dangorogoro/DangoromouseZero-PCB/pcb/dxf/top_board.dxf

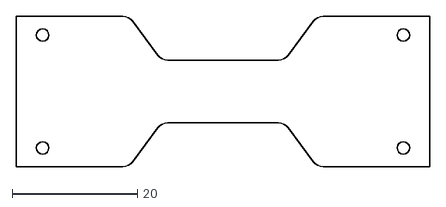
[picture p1: CAD file, 2021-10-21]
pcb/dxf/top_board.dxf
66.0 x 24.0
