dangorogoro/DangoromouseZero-PCB/pcb/dxf/board.dxf

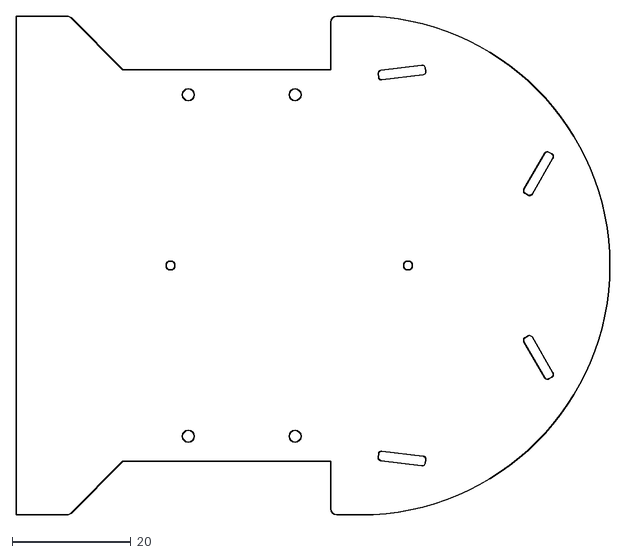
[picture p2: CAD file, 2021-10-18]
pcb/dxf/board.dxf
100.0 x 84.0
