dangorogoro/DangoromouseZero-PCB/pcb/doc/ZeroPCB.pdf

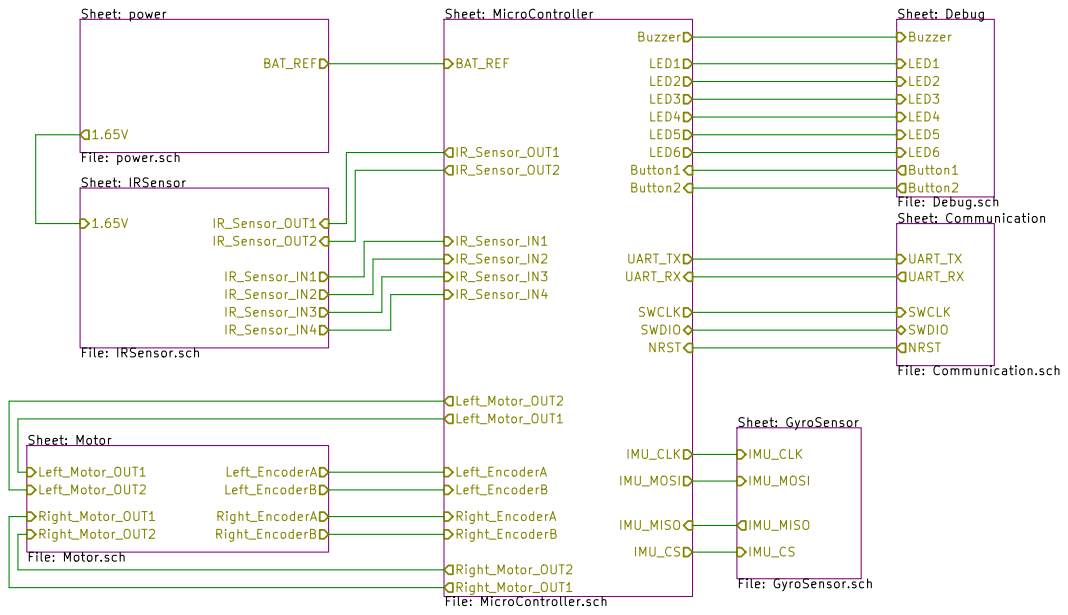
[picture p3: page 1]

File: Debug.sch
Sheet: Communication File: Communication.sch UART_TX UART_RX

Sheet: Motor File: Motor.sch

Id: 1/8 Title: File: ZeroPCB.sch Sheet: /

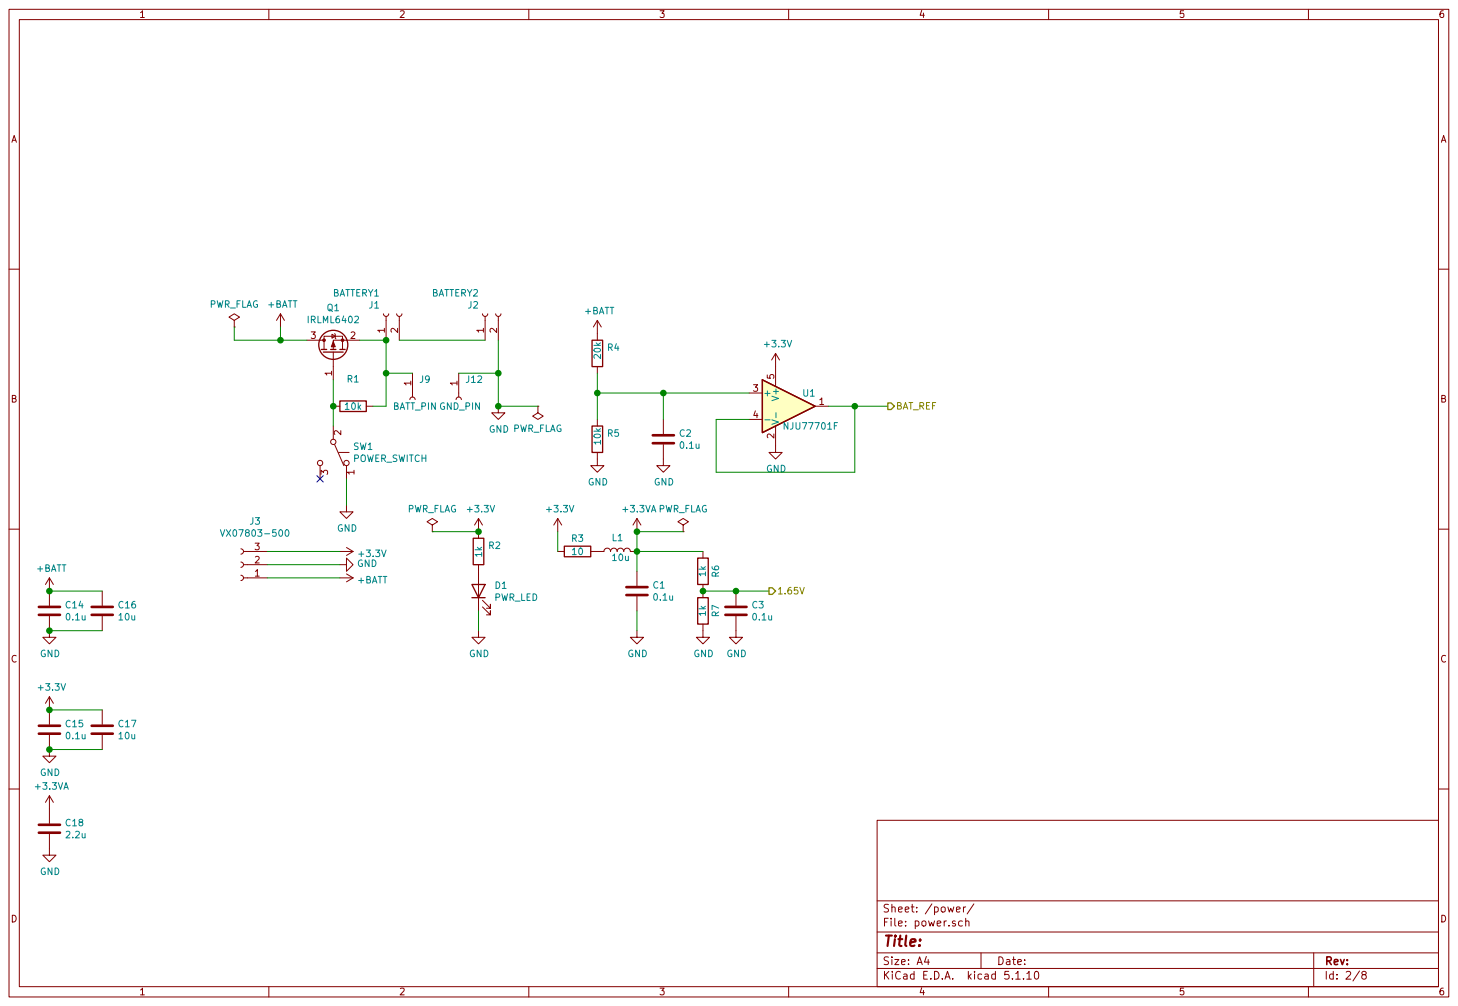
[picture p4: page 2]

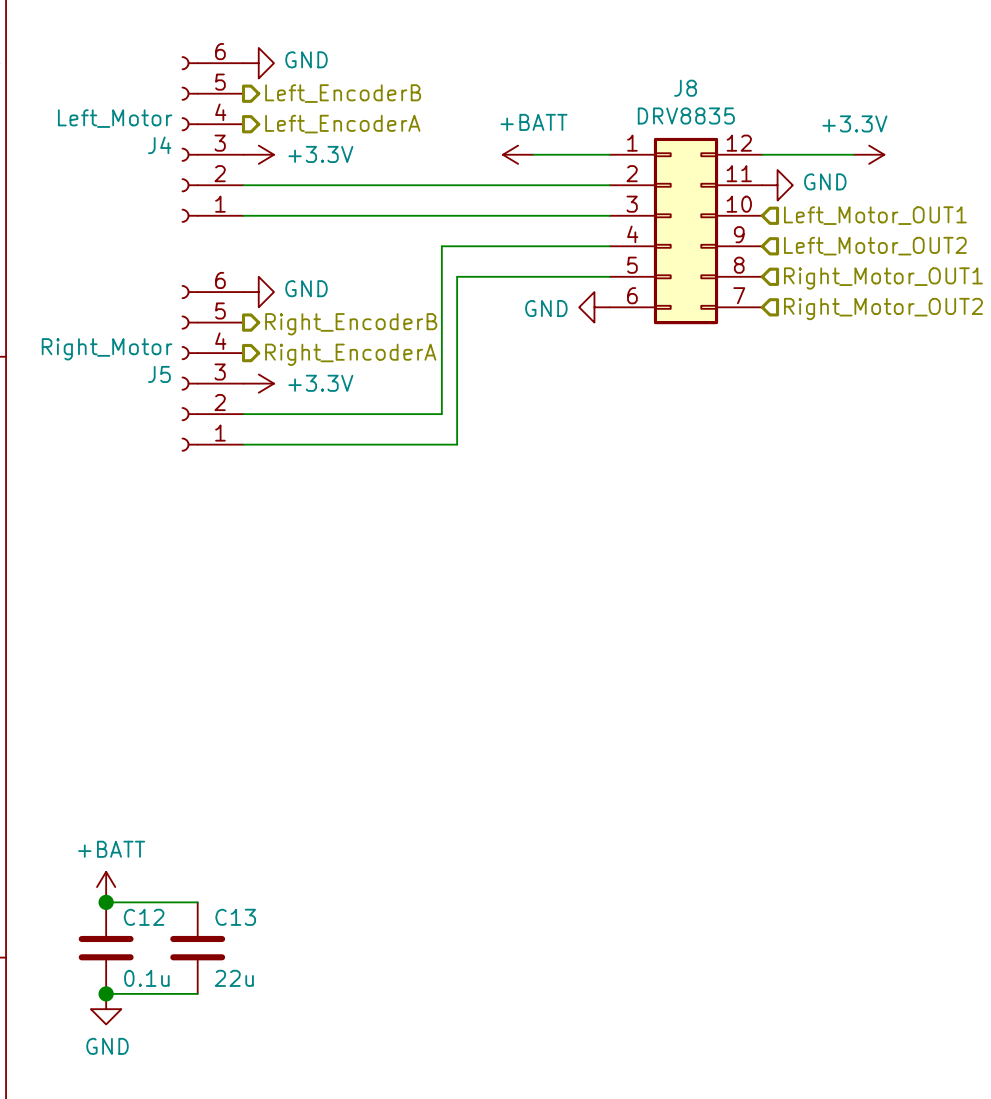
[picture p5: page 3]

Id: 3/8 Title: File: Motor.sch Sheet: /Motor/

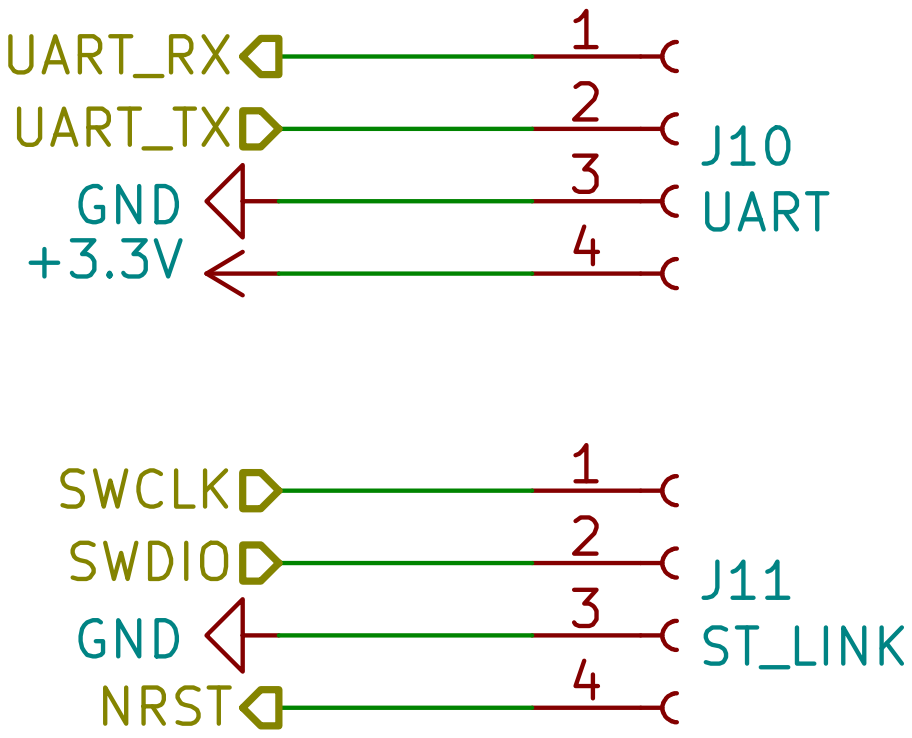
[picture p6: page 4]

Id: 4/8 Title: File: Communication.sch Sheet: /Communication/

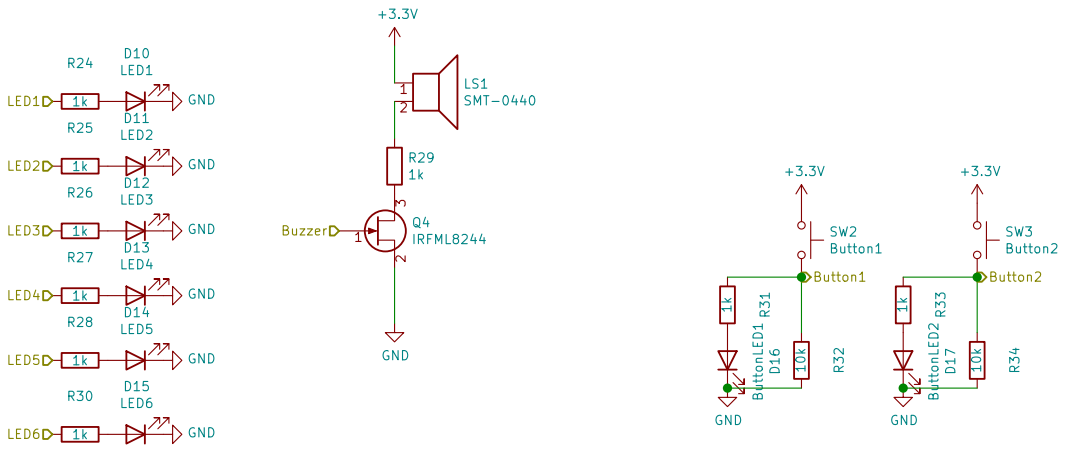
[picture p7: page 5]

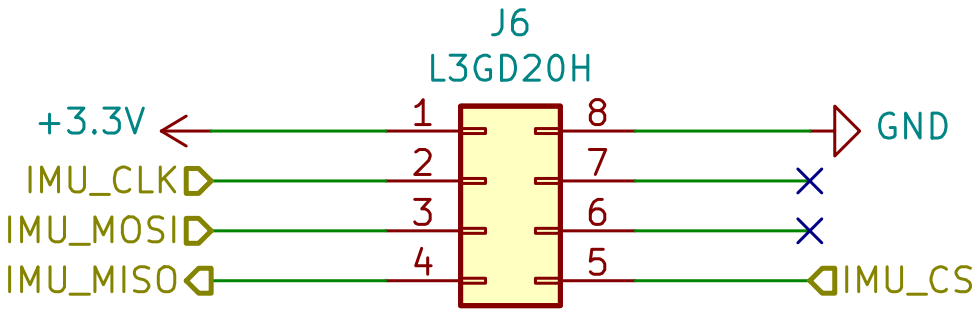
[picture p8: page 6]

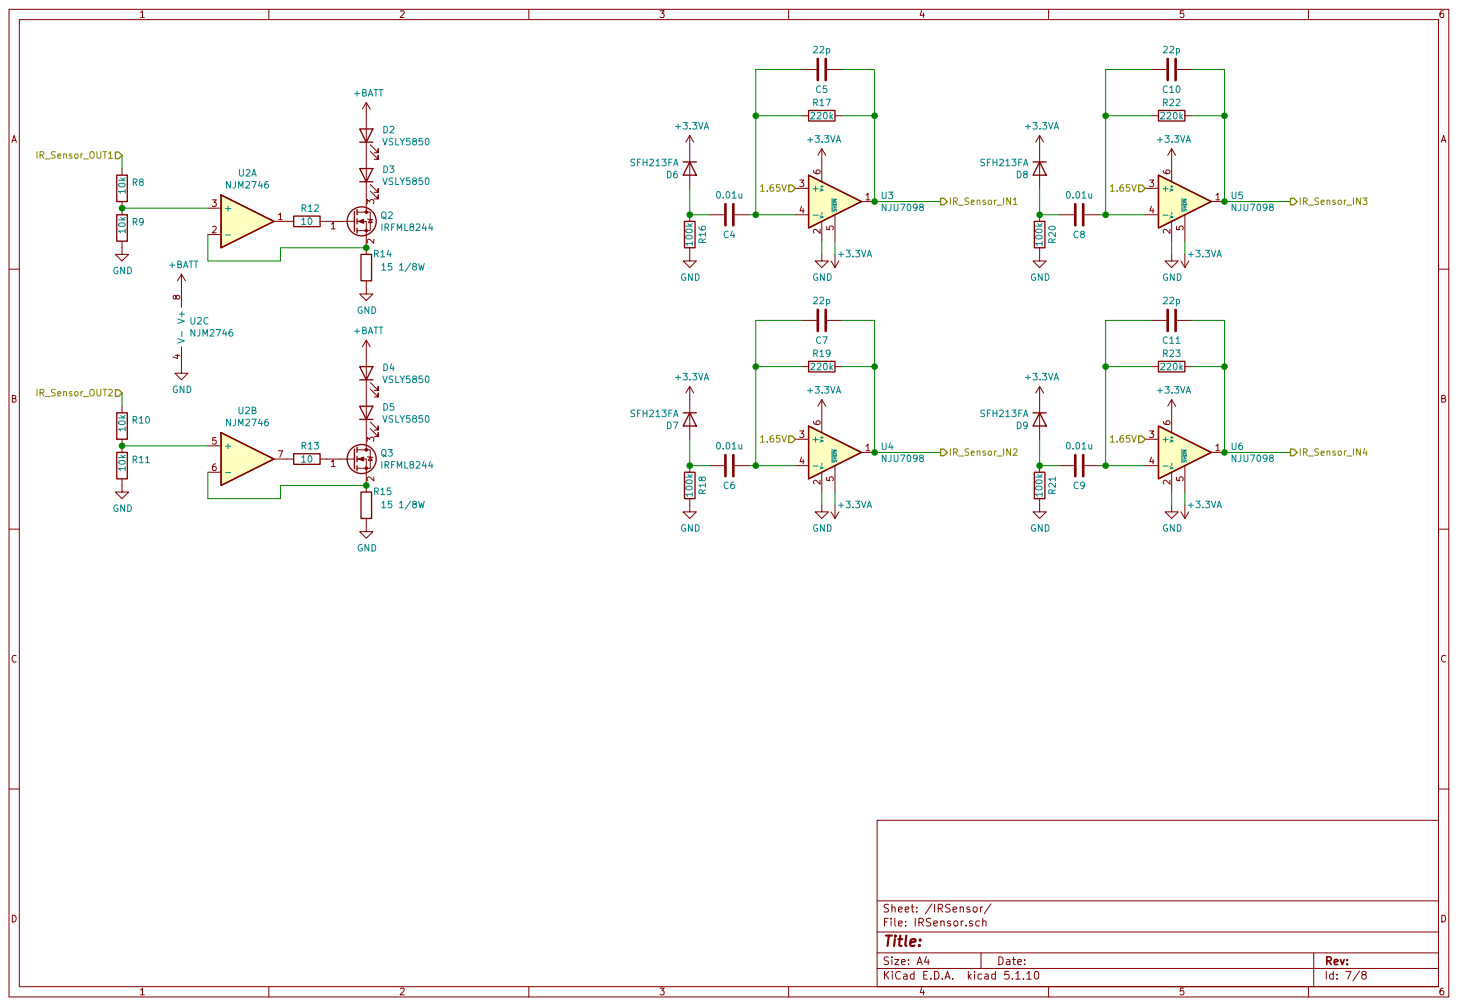
[picture p9: page 7]

Id: 7/8 Title: File: IRSensor.sch Sheet: /IRSensor/

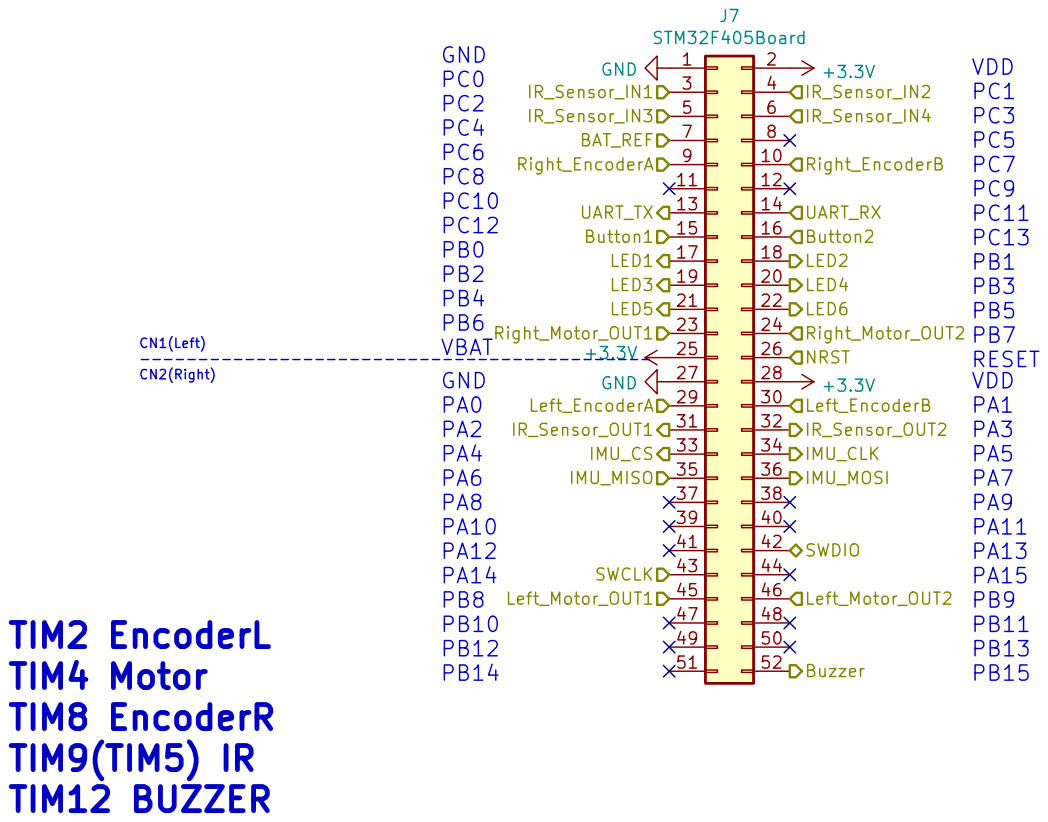
[picture p10: page 8]

Id: 8/8 Title: File: MicroController.sch Sheet: /MicroController/
