dangorogoro/DangoromouseZero-PCB/usb_charger/usb_charger.pdf

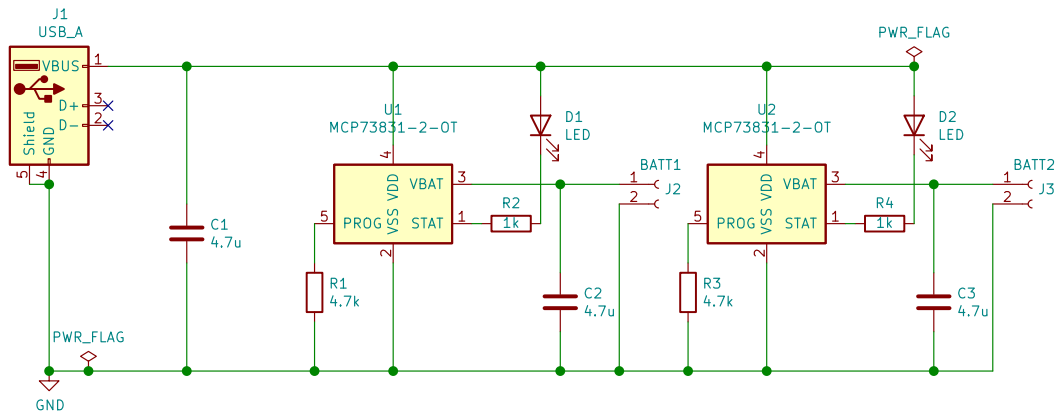
[picture p11: page 1]
