dangorogoro/DangoromouseZero-PCB/pcb/sim/ir_sensor.asc

C1: cap; 22p
C2: cap; 0.01µ
I1: current; SINE(0 3u 10k)
R1: res; 220k
R2: res; 100k
U2: nju77701
V1: voltage; 3.3
V2: voltage; 1.65
Named nets: 0, 3.3V, 1.65V, Vout, V-, V+
.tran 2ms
