dangorogoro/DangoromouseZero-PCB/(list of files, drawings)

Other design files:
pcb/autoroute/ZeroPCB.dsn
usb_charger/autorouter/usb_charger.dsn
