dangorogoro/DangoromouseZero-PCB/pcb/ZeroPCB.kicad_pcb

## KiCad design pcb/ZeroPCB.kicad_pcb (2021-10-31)

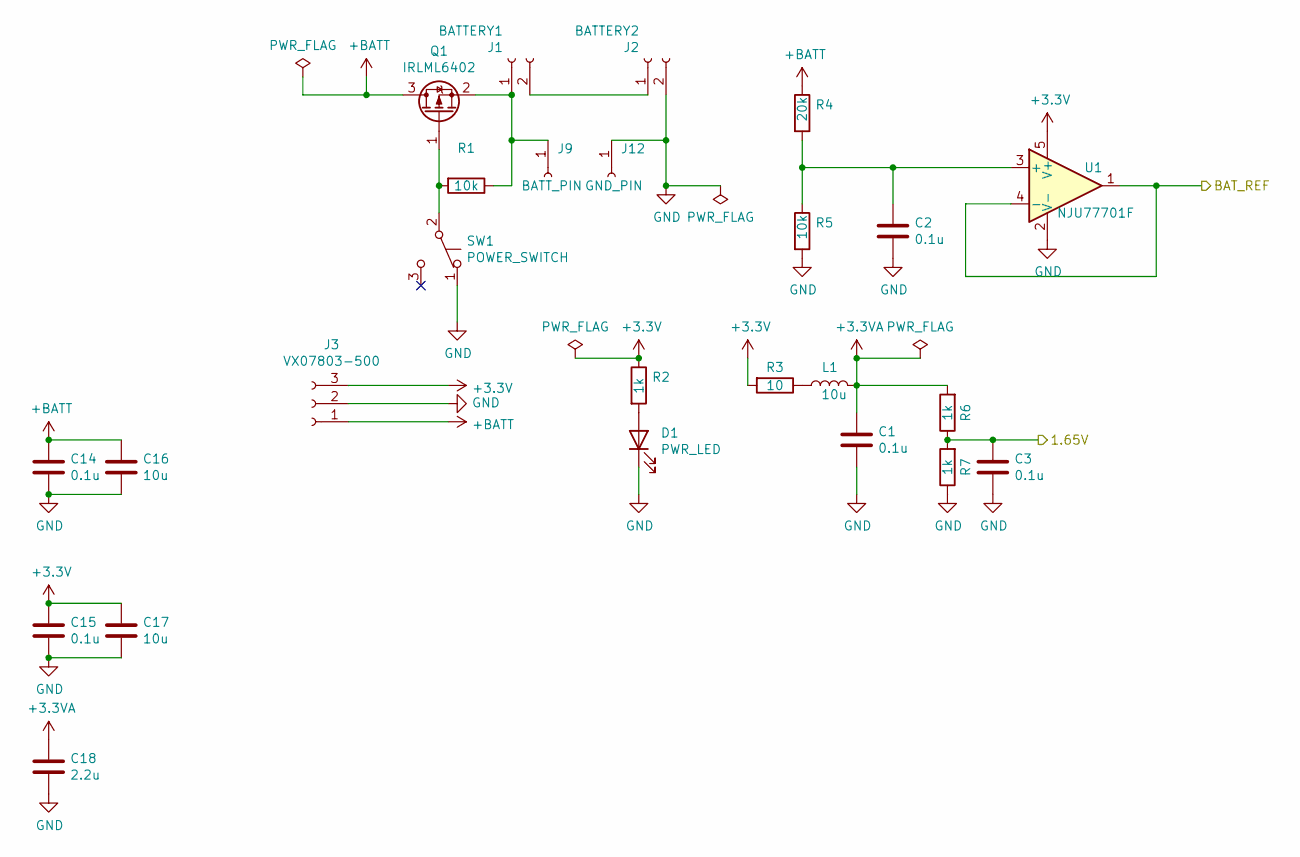
[picture p12: schematic power.sch]

Parts:
C1, C2, C3, C14, C15: 0.1u; C_0603_HandSoldering
C16, C17: 10u; C_0603_HandSoldering
C18: 2.2u; C_0603_HandSoldering
D1: PWR_LED; LED_0603_HandSoldering
J1: BATTERY1; Molex_PicoBlade_53047-0210_02x1.25mm_Straight
J2: BATTERY2; Molex_PicoBlade_53047-0210_02x1.25mm_Straight
J3: VX07803-500; Pin_Header_Straight_1x03_Pitch2.54mm
J9: BATT_PIN; Pin_Header_Straight_1x01_Pitch2.54mm
J12: GND_PIN; Pin_Header_Straight_1x01_Pitch2.54mm
L1: 10u; R_1210_HandSoldering
Q1: IRLML6402; SOT-23
R1, R5: 10k; R_0603_HandSoldering
R2, R6, R7: 1k; R_0603_HandSoldering
R3: 10; R_0603_HandSoldering
R4: 20k; R_0603_HandSoldering
SW1: POWER_SWITCH; Pin_Header_Straight_1x03_Pitch2.54mm
U1: NJU77701F; SOT-23-5_HandSoldering

Connections:
+3.3VA: C1.1, C18.1, L1.2, R6.2; also elsewhere on the board
+3V3: C15.1, C17.1, J3.3, R2.1, R3.2, U1.5 (V+); also elsewhere on the board
+BATT: C14.1, C16.1, J3.1, Q1.3 (D), R4.1; also elsewhere on the board
/IRSensor/1.65V: C3.1, R6.1, R7.2; also elsewhere on the board
/MicroController/BAT_REF: U1.1, U1.4 (-); also elsewhere on the board
GND: C1.2, C2.2, C3.2, C14.2, C15.2, C16.2, C17.2, C18.2, D1.1 (K), J2.2, J3.2, J12.1, R5.2, R7.1, SW1.1 (A), U1.2 (V-); also elsewhere on the board
unnamed: C2.1, R4.2, R5.1, U1.3 (+)
unnamed: D1.2 (A), R2.2
unnamed: J1.1, J9.1, Q1.2 (S), R1.1
unnamed: J1.2, J2.1
unnamed: L1.1, R3.1
unnamed: Q1.1 (G), R1.2, SW1.2 (B)

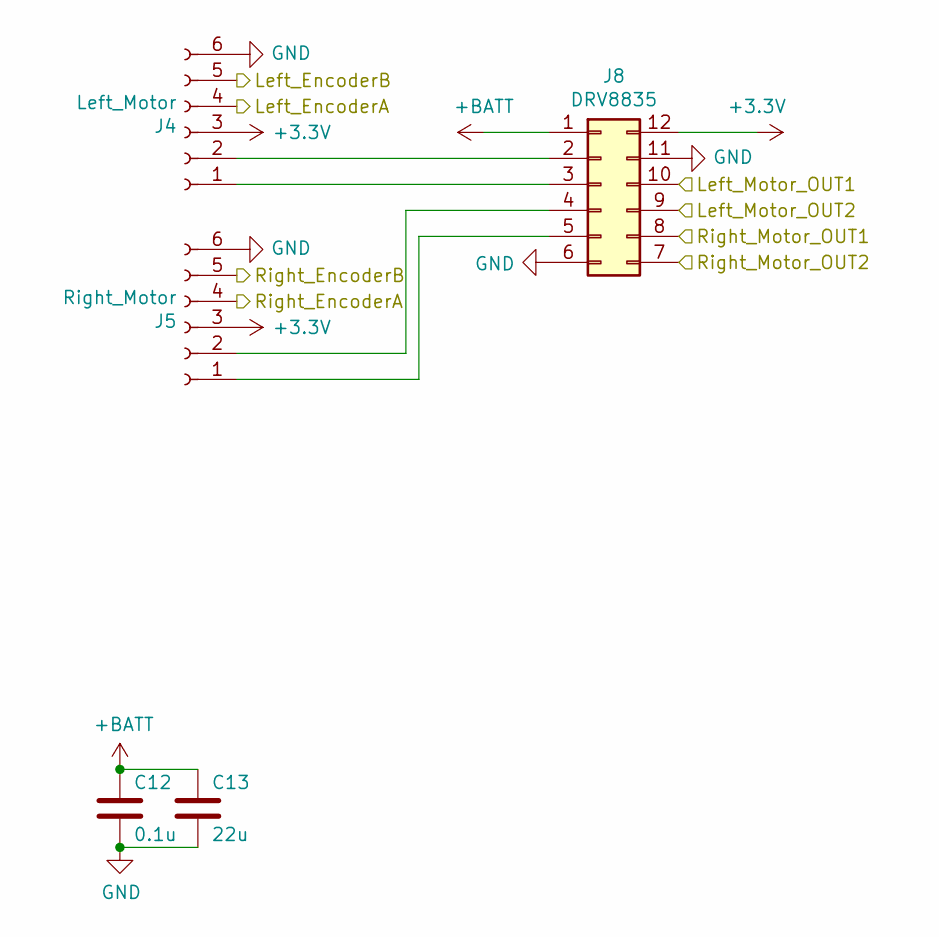
[picture p13: schematic Motor.sch]

Parts:
C12: 0.1u; C_0603_HandSoldering
C13: 22u; C_0805_HandSoldering
J4: Left_Motor; JST_XH_B6B-XH-AM_1x06_P2.50mm_Vertical
J5: Right_Motor; JST_XH_B6B-XH-AM_1x06_P2.50mm_Vertical
J8: DRV8835; DRV8835Board

Connections:
+3V3: J4.3, J5.3, J8.12; also elsewhere on the board
+BATT: C12.1, C13.1, J8.1; also elsewhere on the board
/MicroController/Left_EncoderA: J4.4; also elsewhere on the board
/MicroController/Left_EncoderB: J4.5; also elsewhere on the board
/MicroController/Left_Motor_OUT1: J8.10; also elsewhere on the board
/MicroController/Left_Motor_OUT2: J8.9; also elsewhere on the board
/MicroController/Right_EncoderA: J5.4; also elsewhere on the board
/MicroController/Right_EncoderB: J5.5; also elsewhere on the board
/MicroController/Right_Motor_OUT1: J8.8; also elsewhere on the board
/MicroController/Right_Motor_OUT2: J8.7; also elsewhere on the board
GND: C12.2, C13.2, J4.6, J5.6, J8.6, J8.11; also elsewhere on the board
unnamed: J4.1, J8.3
unnamed: J4.2, J8.2
unnamed: J5.1, J8.5
unnamed: J5.2, J8.4

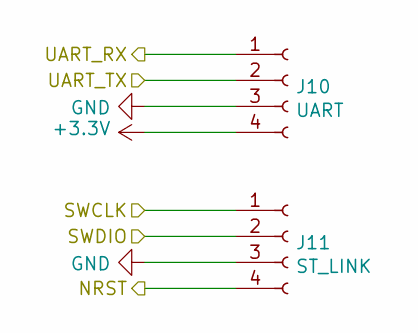
[picture p14: schematic Communication.sch]

Parts:
J10: UART; JST_SH_BM04B-SRSS-TB_1x04-1MP_P1.00mm_Vertical
J11: ST_LINK; JST_SH_BM04B-SRSS-TB_1x04-1MP_P1.00mm_Vertical

Connections:
+3V3: J10.4; also elsewhere on the board
/Communication/NRST: J11.4; also elsewhere on the board
/Communication/SWCLK: J11.1; also elsewhere on the board
/Communication/SWDIO: J11.2; also elsewhere on the board
/Communication/UART_RX: J10.1; also elsewhere on the board
/Communication/UART_TX: J10.2; also elsewhere on the board
GND: J10.3, J11.3; also elsewhere on the board

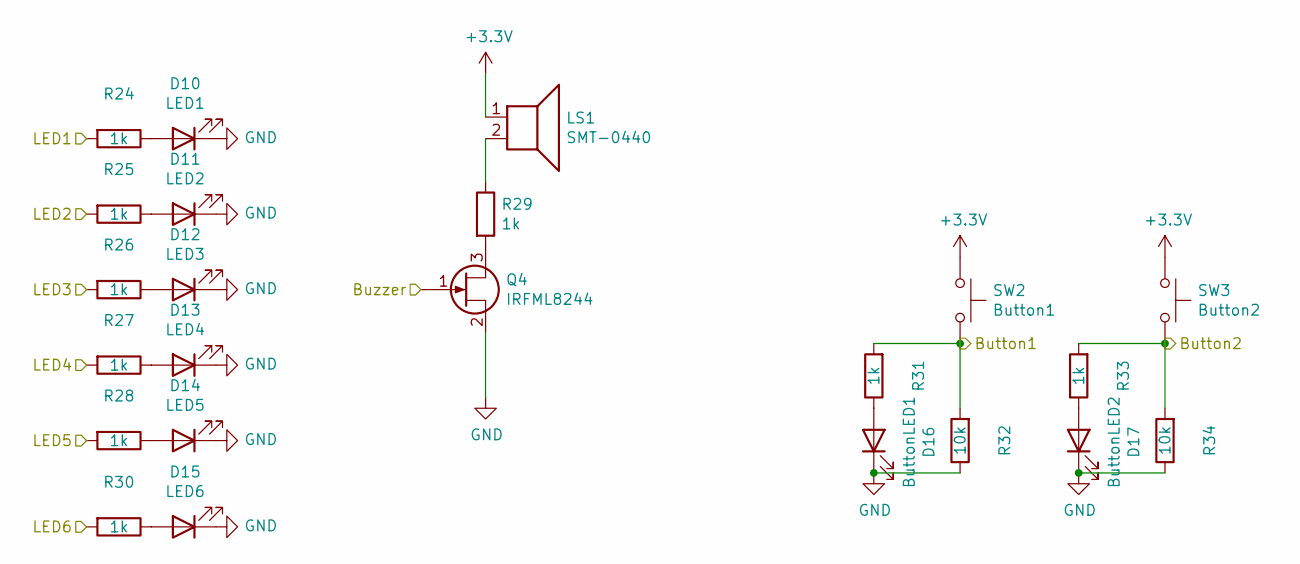
[picture p15: schematic Debug.sch]

Parts:
D10: LED1; LED_0603_HandSoldering
D11: LED2; LED_0603_HandSoldering
D12: LED3; LED_0603_HandSoldering
D13: LED4; LED_0603_HandSoldering
D14: LED5; LED_0603_HandSoldering
D15: LED6; LED_0603_HandSoldering
D16: ButtonLED1; LED_0603_HandSoldering
D17: ButtonLED2; LED_0603_HandSoldering
LS1: SMT-0440; SMT-0440-S-R
Q4: IRFML8244; SOT-23
R24, R25, R26, R27, R28, R29, R30, R31, R33: 1k; R_0603_HandSoldering
R32, R34: 10k; R_0603_HandSoldering
SW2: Button1; SW_SPST_EVQP2
SW3: Button2; SW_SPST_EVQP2

Connections:
+3V3: LS1.1, SW2.1, SW3.1; also elsewhere on the board
/Debug/Button1: R31.2, R32.2, SW2.2; also elsewhere on the board
/Debug/Button2: R33.2, R34.2, SW3.2; also elsewhere on the board
/Debug/Buzzer: Q4.1 (G); also elsewhere on the board
/Debug/LED1: R24.2; also elsewhere on the board
/Debug/LED2: R25.2; also elsewhere on the board
/Debug/LED3: R26.2; also elsewhere on the board
/Debug/LED4: R27.2; also elsewhere on the board
/Debug/LED5: R28.2; also elsewhere on the board
/Debug/LED6: R30.2; also elsewhere on the board
GND: D10.1 (K), D11.1 (K), D12.1 (K), D13.1 (K), D14.1 (K), D15.1 (K), D16.1 (K), D17.1 (K), Q4.2 (S), R32.1, R34.1; also elsewhere on the board
unnamed: D10.2 (A), R24.1
unnamed: D11.2 (A), R25.1
unnamed: D12.2 (A), R26.1
unnamed: D13.2 (A), R27.1
unnamed: D14.2 (A), R28.1
unnamed: D15.2 (A), R30.1
unnamed: D16.2 (A), R31.1
unnamed: D17.2 (A), R33.1
unnamed: LS1.2, R29.1
unnamed: Q4.3 (D), R29.2

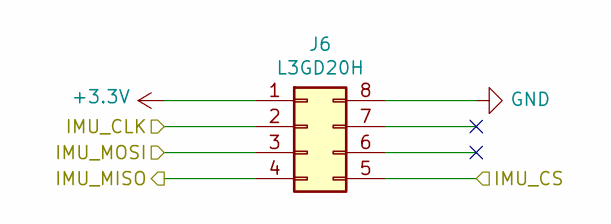
[picture p16: schematic GyroSensor.sch]

Parts:
J6: L3GD20H; L3GD20HBoard

Connections:
+3V3: J6.1; also elsewhere on the board
/GyroSensor/IMU_CLK: J6.2; also elsewhere on the board
/GyroSensor/IMU_CS: J6.5; also elsewhere on the board
/GyroSensor/IMU_MISO: J6.4; also elsewhere on the board
/GyroSensor/IMU_MOSI: J6.3; also elsewhere on the board
GND: J6.8; also elsewhere on the board

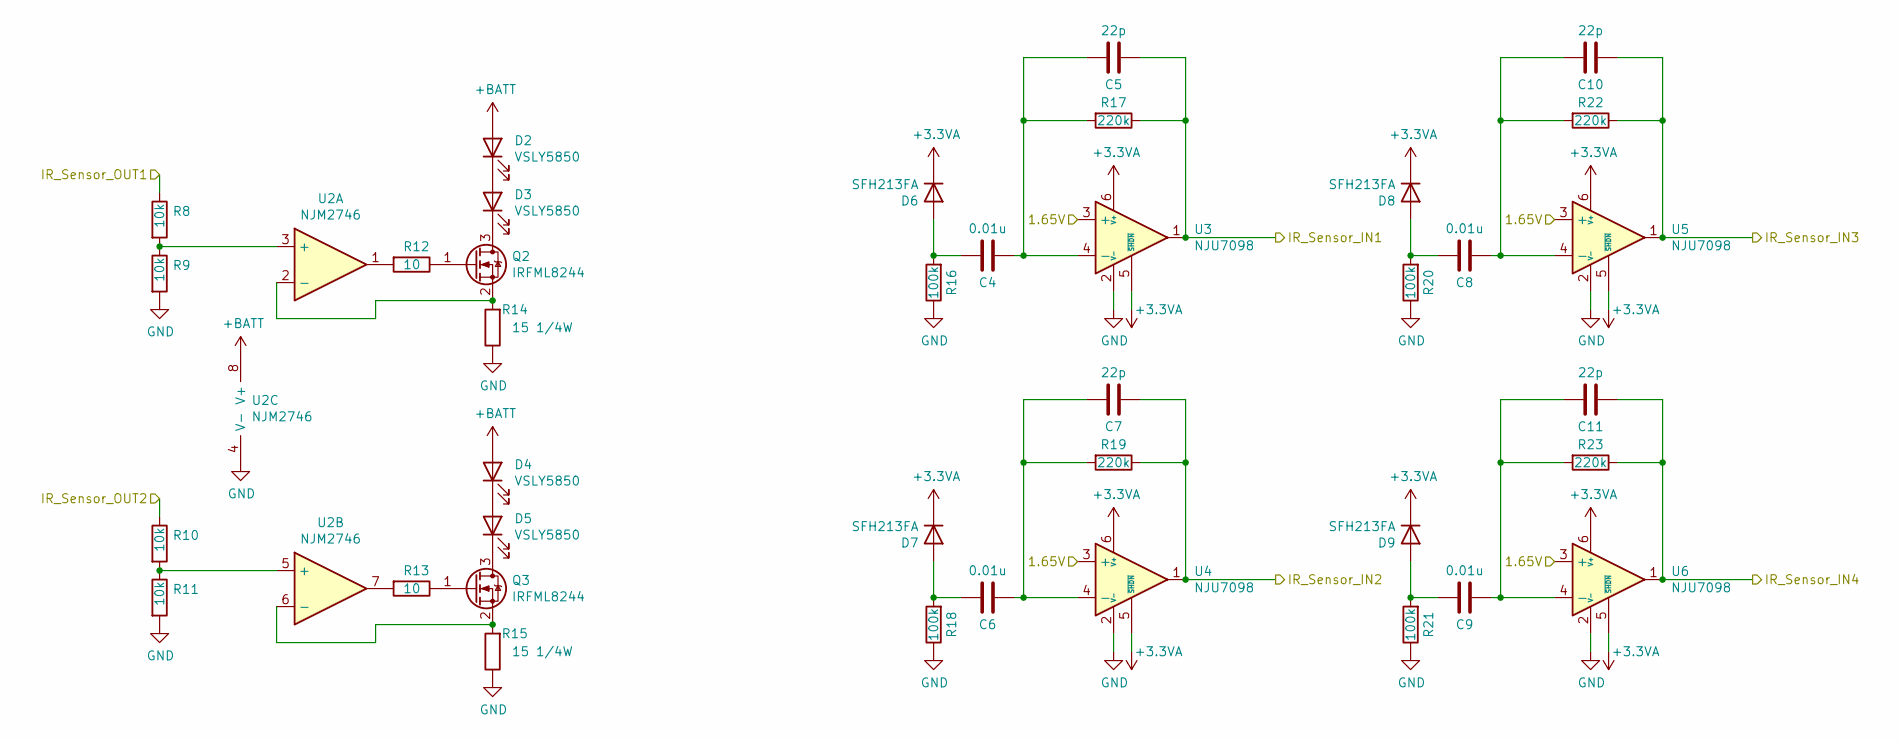
[picture p17: schematic IRSensor.sch]

Parts:
C4, C6, C8, C9: 0.01u; C_0603_HandSoldering
C5, C7, C10, C11: 22p; C_0603_HandSoldering
D2, D3, D4, D5: VSLY5850; LED_D5.0mm_Horizontal_O1.27mm_Z3.0mm
D6, D7, D8, D9: SFH213FA; LED_D5.0mm_Horizontal_O1.27mm_Z3.0mm
Q2, Q3: IRFML8244; SOT-23
R8, R9, R10, R11: 10k; R_0603_HandSoldering
R12, R13: 10; R_0603_HandSoldering
R14, R15: 15 1/4W; R_0805_HandSoldering
R16, R18, R20, R21: 100k; R_0603_HandSoldering
R17, R19, R22, R23: 220k; R_0603_HandSoldering
U2: NJM2746; SOIC-8_3.9x4.9mm_Pitch1.27mm
U3, U4, U5, U6: NJU7098; SOT-23-6_Handsoldering

Connections:
+3.3VA: D6.1 (K), D7.1 (K), D8.1 (K), D9.1 (K), U3.5 (~SHDN), U3.6 (V+), U4.5 (~SHDN), U4.6 (V+), U5.5 (~SHDN), U5.6 (V+), U6.5 (~SHDN), U6.6 (V+); also elsewhere on the board
+BATT: D2.2 (A), D4.2 (A), U2.8 (V+); also elsewhere on the board
/IRSensor/1.65V: U3.3 (+), U4.3 (+), U5.3 (+), U6.3 (+); also elsewhere on the board
/IRSensor/IR_Sensor_IN1: C5.1, R17.1, U3.1; also elsewhere on the board
/IRSensor/IR_Sensor_IN2: C7.1, R19.1, U4.1; also elsewhere on the board
/IRSensor/IR_Sensor_IN3: C10.1, R22.1, U5.1; also elsewhere on the board
/IRSensor/IR_Sensor_IN4: C11.1, R23.1, U6.1; also elsewhere on the board
/IRSensor/IR_Sensor_OUT1: R8.1; also elsewhere on the board
/IRSensor/IR_Sensor_OUT2: R10.1; also elsewhere on the board
GND: R9.2, R11.2, R14.1, R15.1, R16.1, R18.1, R20.1, R21.1, U2.4 (V-), U3.2 (V-), U4.2 (V-), U5.2 (V-), U6.2 (V-); also elsewhere on the board
unnamed: C4.1, C5.2, R17.2, U3.4 (-)
unnamed: C4.2, D6.2 (A), R16.2
unnamed: C6.1, C7.2, R19.2, U4.4 (-)
unnamed: C6.2, D7.2 (A), R18.2
unnamed: C8.2, D8.2 (A), R20.2
unnamed: C9.2, D9.2 (A), R21.2
unnamed: C8.1, C10.2, R22.2, U5.4 (-)
unnamed: C9.1, C11.2, R23.2, U6.4 (-)
unnamed: D2.1 (K), D3.2 (A)
unnamed: D3.1 (K), Q2.3 (D)
unnamed: D4.1 (K), D5.2 (A)
unnamed: D5.1 (K), Q3.3 (D)
unnamed: Q2.1 (G), R12.1
unnamed: Q2.2 (S), R14.2, U2.2 (-)
unnamed: Q3.1 (G), R13.1
unnamed: Q3.2 (S), R15.2, U2.6 (-)
unnamed: R8.2, R9.1, U2.3 (+)
unnamed: R10.2, R11.1, U2.5 (+)
unnamed: R12.2, U2.1
unnamed: R13.2, U2.7

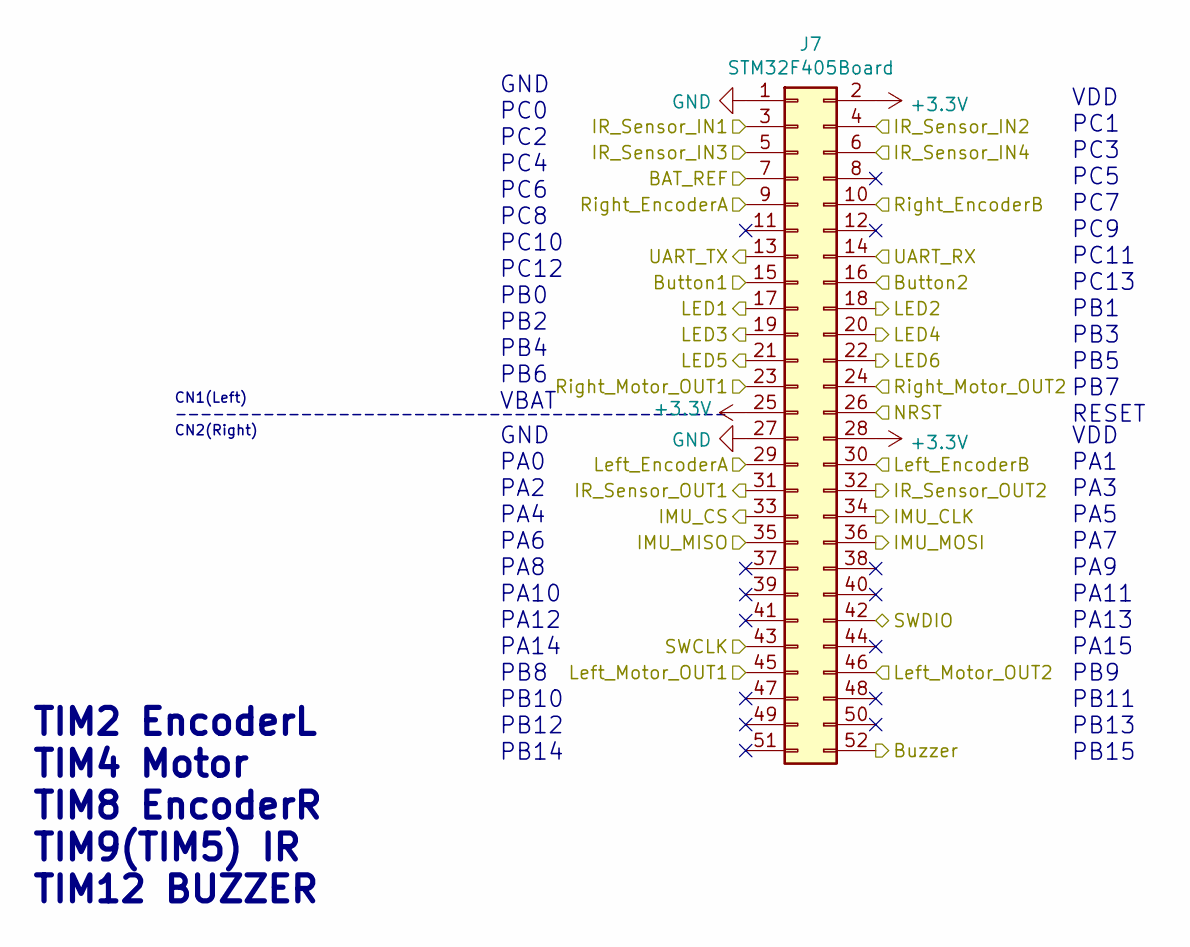
[picture p18: schematic MicroController.sch]

Parts:
J7: STM32F405Board

Connections:
+3V3: J7.2, J7.25, J7.28; also elsewhere on the board
/Communication/NRST: J7.26; also elsewhere on the board
/Communication/SWCLK: J7.43; also elsewhere on the board
/Communication/SWDIO: J7.42; also elsewhere on the board
/Communication/UART_RX: J7.14; also elsewhere on the board
/Communication/UART_TX: J7.13; also elsewhere on the board
/Debug/Button1: J7.15; also elsewhere on the board
/Debug/Button2: J7.16; also elsewhere on the board
/Debug/Buzzer: J7.52; also elsewhere on the board
/Debug/LED1: J7.17; also elsewhere on the board
/Debug/LED2: J7.18; also elsewhere on the board
/Debug/LED3: J7.19; also elsewhere on the board
/Debug/LED4: J7.20; also elsewhere on the board
/Debug/LED5: J7.21; also elsewhere on the board
/Debug/LED6: J7.22; also elsewhere on the board
/GyroSensor/IMU_CLK: J7.34; also elsewhere on the board
/GyroSensor/IMU_CS: J7.33; also elsewhere on the board
/GyroSensor/IMU_MISO: J7.35; also elsewhere on the board
/GyroSensor/IMU_MOSI: J7.36; also elsewhere on the board
/IRSensor/IR_Sensor_IN1: J7.3; also elsewhere on the board
/IRSensor/IR_Sensor_IN2: J7.4; also elsewhere on the board
/IRSensor/IR_Sensor_IN3: J7.5; also elsewhere on the board
/IRSensor/IR_Sensor_IN4: J7.6; also elsewhere on the board
/IRSensor/IR_Sensor_OUT1: J7.31; also elsewhere on the board
/IRSensor/IR_Sensor_OUT2: J7.32; also elsewhere on the board
/MicroController/BAT_REF: J7.7; also elsewhere on the board
/MicroController/Left_EncoderA: J7.29; also elsewhere on the board
/MicroController/Left_EncoderB: J7.30; also elsewhere on the board
/MicroController/Left_Motor_OUT1: J7.45; also elsewhere on the board
/MicroController/Left_Motor_OUT2: J7.46; also elsewhere on the board
/MicroController/Right_EncoderA: J7.9; also elsewhere on the board
/MicroController/Right_EncoderB: J7.10; also elsewhere on the board
/MicroController/Right_Motor_OUT1: J7.23; also elsewhere on the board
/MicroController/Right_Motor_OUT2: J7.24; also elsewhere on the board
GND: J7.1, J7.27; also elsewhere on the board

Notes on the sheet:
GND PC0 PC2 PC4 PC6 PC8 PC10 PC12 PB0 PB2 PB4 PB6 VBAT
VDD PC1 PC3 PC5 PC7 PC9 PC11 PC13 PB1 PB3 PB5 PB7 RESET
TIM2 EncoderL TIM4 Motor TIM8 EncoderR TIM9(TIM5) IR TIM12 BUZZER
GND PA0 PA2 PA4 PA6 PA8 PA10 PA12 PA14 PB8 PB10 PB12 PB14
VDD PA1 PA3 PA5 PA7 PA9 PA11 PA13 PA15 PB9 PB11 PB13 PB15
CN1(Left) -------------------------------------------- CN2(Right)

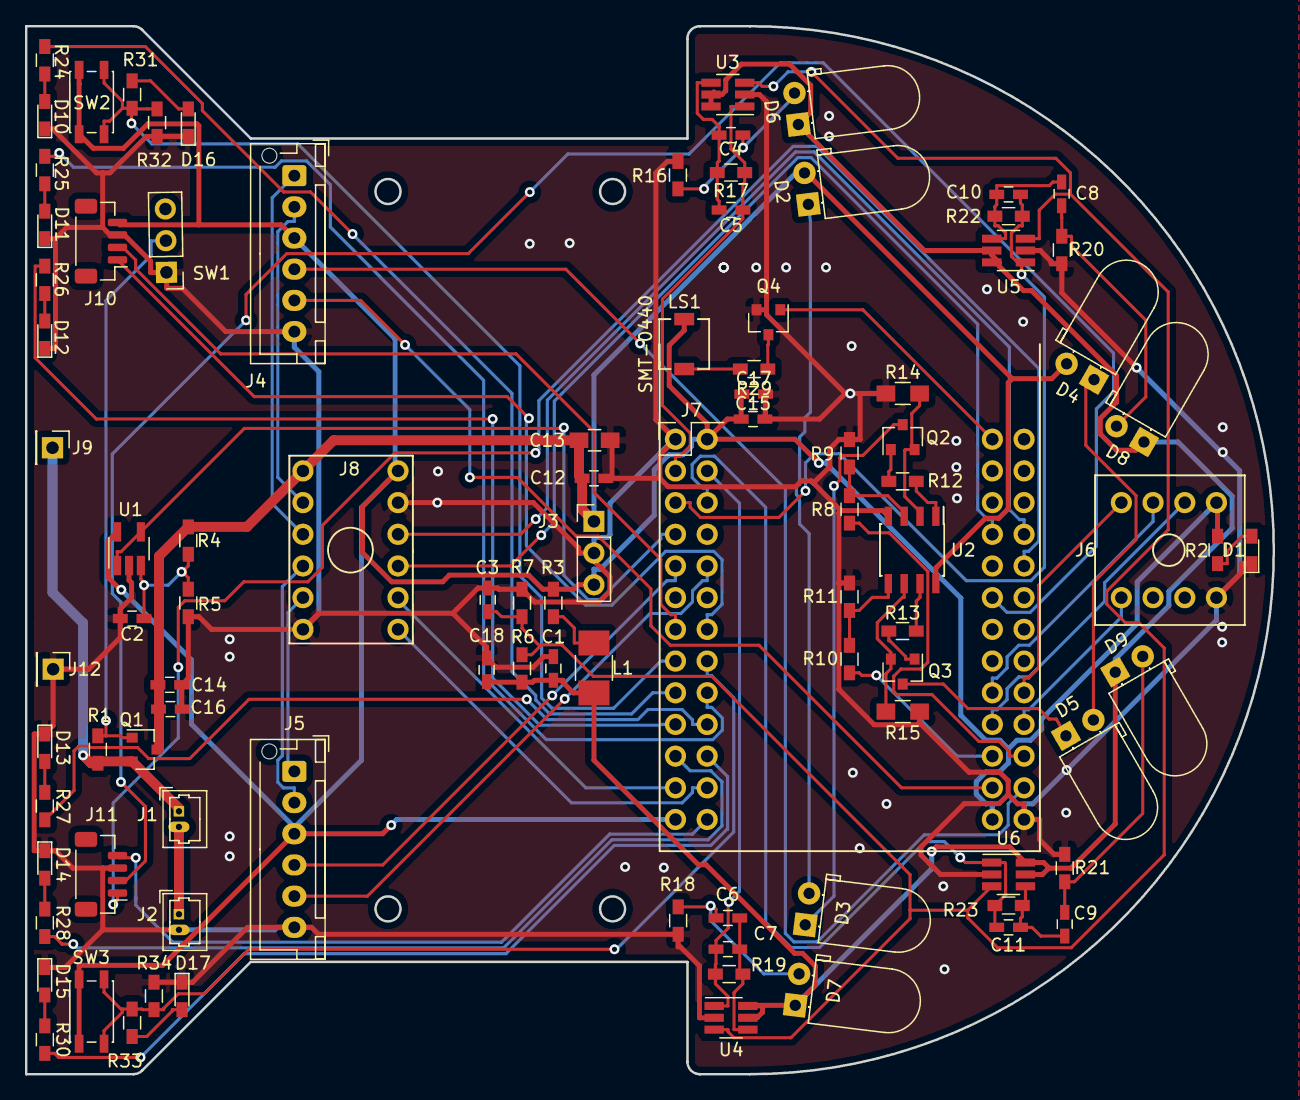
[picture p19: board ZeroPCB.kicad_pcb from above]

Board: 2 copper layers, 100.0 x 84.0 mm, 96 parts (0 on the bottom side), 78 nets.
