dangorogoro/DangoromouseZero-PCB/firmware/strawberry.ioc

Mcu.UserName=STM32F405RGTx
PA0-WKUP.Signal=S_TIM2_CH1_ETR
PA1.Signal=S_TIM2_CH2
PA13.Signal=SYS_JTMS-SWDIO
PA14.Signal=SYS_JTCK-SWCLK
PA2.Signal=S_TIM9_CH1
PA3.Signal=S_TIM9_CH2
PA4.Signal=SPI1_NSS
PA5.Signal=SPI1_SCK
PA6.Signal=SPI1_MISO
PA7.Signal=SPI1_MOSI
PB0.Signal=GPIO_Output
PB1.Signal=GPIO_Analog
PB15.Signal=S_TIM12_CH2
PB2.Signal=GPIO_Output
PB3.Signal=GPIO_Output
PB4.Signal=GPIO_Output
PB5.Signal=GPIO_Output
PB6.Signal=S_TIM4_CH1
PB7.Signal=S_TIM4_CH2
PB8.Signal=S_TIM4_CH3
PB9.Signal=S_TIM4_CH4
PC0.Signal=ADCx_IN10
PC1.Signal=ADCx_IN11
PC10.Signal=UART4_TX
PC11.Signal=UART4_RX
PC12.Signal=GPIO_Input
PC13-ANTI_TAMP.Signal=GPIO_Input
PC2.Signal=ADCx_IN12
PC3.Signal=ADCx_IN13
PC4.Signal=ADCx_IN14
PC6.Signal=S_TIM8_CH1
