dangorogoro/DangoromouseZero-PCB/(commit log)

2021-10-11 Finish the schematic
    [Communication.sch, Debug.sch, IRSensor.sch, MicroController.sch, Motor.sch, ZeroPCB.sch, power.sch]
2021-10-18 Add dxf data
    [board.dxf, top_board.dxf]
2021-10-18 Add footprint
2021-10-18 Make netlist
    [Communication.sch, Debug.sch, GyroSensor.sch, IRSensor.sch, MicroController.sch, Motor.sch, ZeroPCB.sch, power.sch]
2021-10-19 Add footprint for board module
2021-10-19 Update schematic
    [GyroSensor.sch, MicroController.sch, Motor.sch, ZeroPCB.kicad_pcb]
2021-10-27 Run autorouter
    [ZeroPCB.dsn, ZeroPCB.kicad_pcb]
2021-10-27 MXのやつ追加
2021-10-31 Add LTSpice project for ir sensor
2021-10-31 Add a logo footprint
2021-10-31 Make the project for usb charger
    [usb_charger.dsn, usb_charger.kicad_pcb, usb_charger.sch]
2021-10-31 Update pcb
    [Debug.sch, IRSensor.sch, MicroController.sch, ZeroPCB.kicad_pcb, power.sch]
2021-10-31 Add gerder data
    [ZeroPCB-B_Cu.gbr, ZeroPCB-B_Mask.gbr, ZeroPCB-B_SilkS.gbr, ZeroPCB-Edge_Cuts.gbr, ZeroPCB-F_Cu.gbr, ZeroPCB-F_Mask.gbr, ZeroPCB-F_SilkS.gbr, ZeroPCB-NPTH.drl]
2021-11-18 Export pdf of schematic for usb charger
2021-11-27 Add bom files
    [ZeroPCB.csv]
2021-11-27 Write about where to buy the parts
    [Communication.sch, Debug.sch, GyroSensor.sch, IRSensor.sch, MicroController.sch, Motor.sch, power.sch]
